sydneyanneturner-droid/ChemE-Cube-Controls-2026/ChemE_Cube_wiring_v11.png

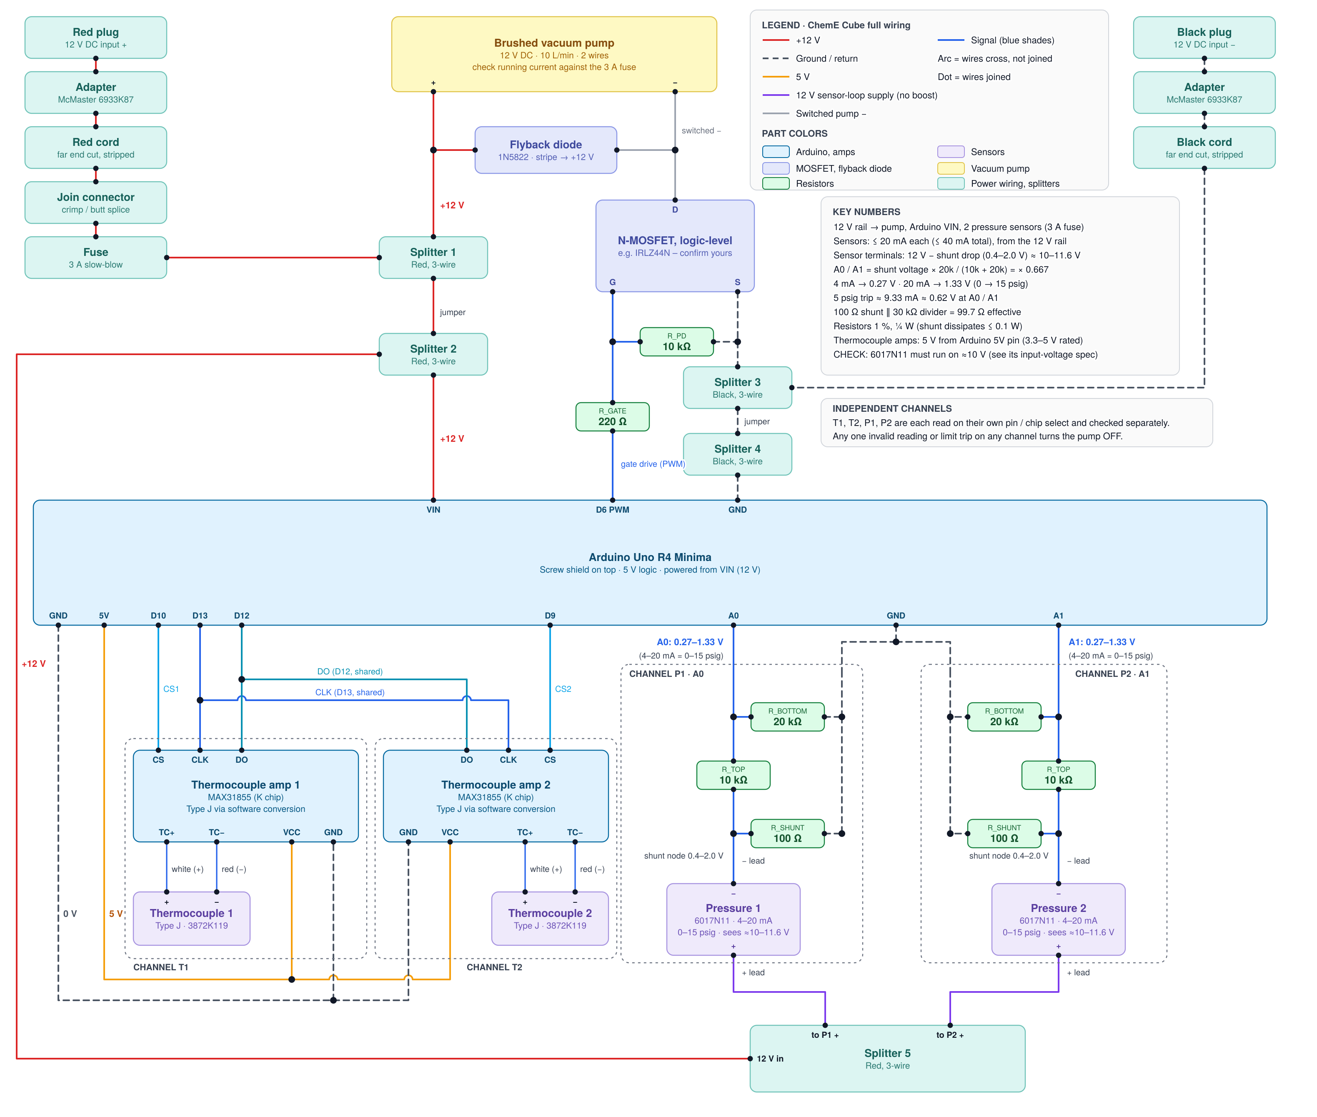
ChemE_Cube_wiring_v11.png
