sydneyanneturner-droid/ChemE-Cube-Controls-2026/(commit log)

2026-09-29 Add temperature and pressure control system
2026-10-19 Rename Main Code to Vacuum Pump Control Source Code (C++) for clarification
2026-10-19 Refactor vacuum pump control for multiple sensors
    Refactor vacuum pump control code to improve readability and maintainability. Added support for multiple pressure sensors and thermocouples. If the pressure and temperature of any sensor exceeds its max allowed value, the vacuum pump turns off and is only turned on again when five seconds of safe readings have been recorded.
2026-10-19 Add README for Arduino Vacuum Pump Controller
    Added comprehensive documentation for the Arduino Uno Vacuum Pump Controller project, including hardware requirements, pin assignments, configuration settings, operational details, fault detection, calibration procedures, and safety considerations.
2026-10-19 Changed minimum pressure calibration value
    This will have to be updated. For the time being, realistic placeholder values were set.
2026-10-19 Added a wiring diagram (V1)
    This is the version 1.0 wiring diagram. It is very rough and some of the wiring is incorrect; however, this is just for initial reference before wiring is finalized and a physical control switch is added to the circuit.
2026-10-24 Rename Vacuum Pump Control Source Code (C++) to Vacuum Pump Control Source Code C++
2026-10-28 Delete Vacuum Pump Control Source Code C++
    Deleted because this assumes the pressure transducers were receiving 24V with a booster.
2026-10-28 Rename Vacuum Pump Control Source Code (C++) (2) to Vacuum Pump Control Source Code (C++) 12V
2026-10-28 Update Vacuum Pump Control Source Code (C++) 12V
    Changed the Mosfet input from D7 to D6
2026-10-29 V6 of the wiring diagram
2026-10-29 V11 of the wiring diagram and the one currently in use
